Sejonhossain/IoT-Based-Hybrid-Fire-Fighting-Robot-with-Real-Time-Monitoring-and-Control-via-a-Web-Based-Dashboard/Firefighter_Circuit_Diagram.jpeg

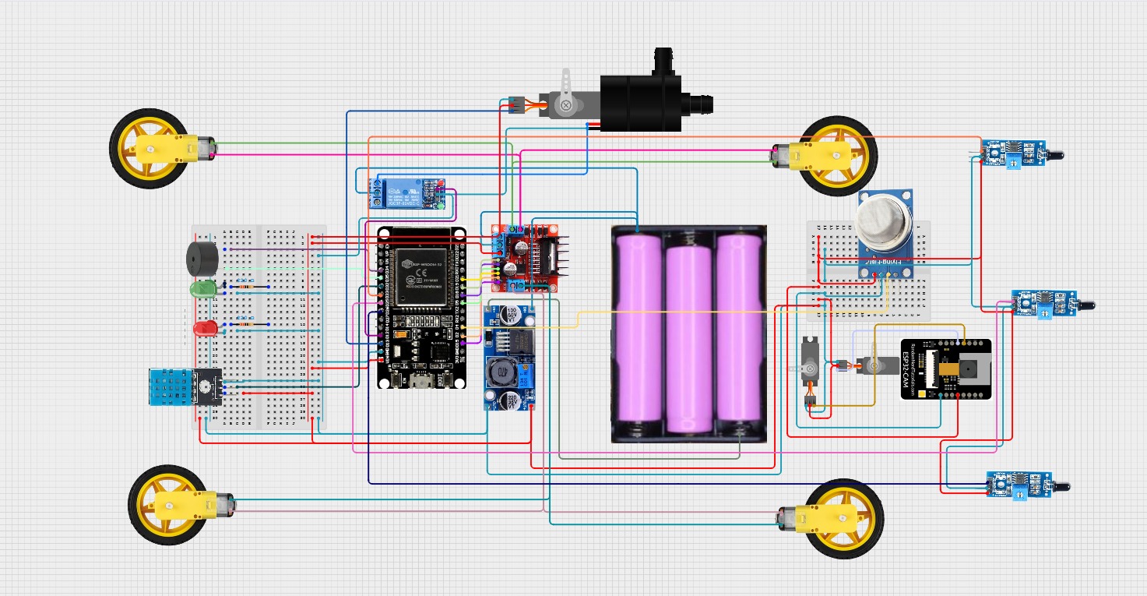
Firefighter_Circuit_Diagram.jpeg
