Sejonhossain/IoT-Based-Hybrid-Fire-Fighting-Robot-with-Real-Time-Monitoring-and-Control-via-a-Web-Based-Dashboard/Project Photos/FireFighter_Web_Dashbaord_1.jpeg

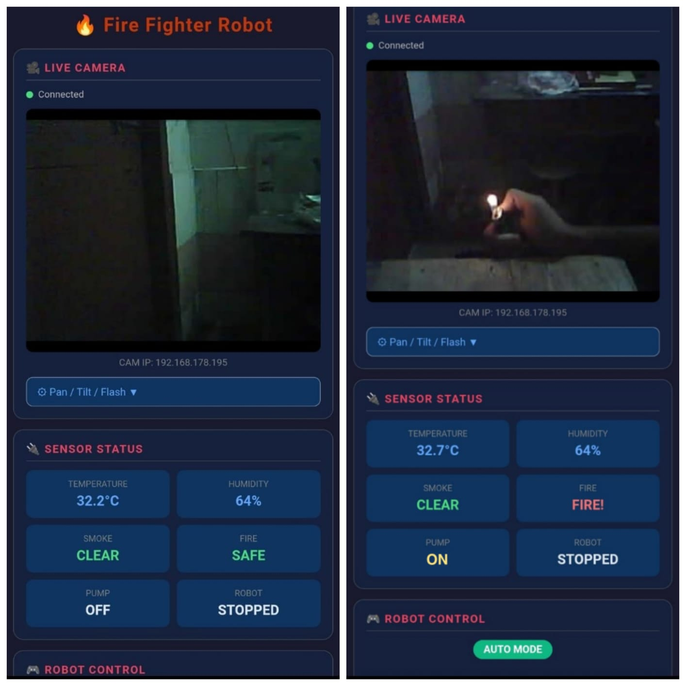
Project Photos/FireFighter_Web_Dashbaord_1.jpeg
