Sejonhossain/IoT-Based-Hybrid-Fire-Fighting-Robot-with-Real-Time-Monitoring-and-Control-via-a-Web-Based-Dashboard/Annexure/Budget.pdf

1

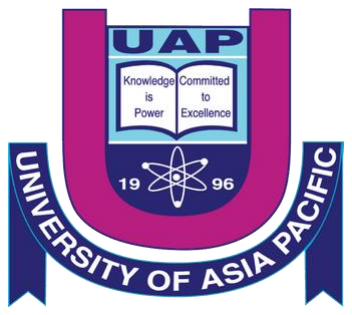
[picture p8: figure]

# University of Asia Pacific

# Department of Computer Science and Engineering

# CSE 438: Robotics Lab

# Annexure (Budget)

Submitted by: | Submitted to:
Name: Dipu Banik | Tasnim Jahin Mowla
Student ID: 22201255 | Lecturer
Name: Bivas Nandan Debnath | Department of Computer Science and Engineering

Student ID: 22201256

Name: Nazim Uddin
Student ID: 22201271

Name: Md. Sejon Hossain
Student ID: 22201272

Section: E2
Semester: 4th Year 1st Semester

2

# Budget of the Project

Number | Components | Quantity | Unit price | Total Price
1 | ESP-32 | 1 | 600 | 600
2 | Flame Sensor | 3 | 65 | 195
3 | Flammable Gas & Smoke Sensor (MQ-2) | 1 | 130 | 130
4 | Analog Temperature Sensor Module (DHT 11) | 1 | 75 | 75
5 | ESP-32 CAM | 1 | 980 | 980
6 | Gear BO Motor (TT dual shaft) | 4 | 85 | 340
7 | Robot Car Wheel | 4 | 75 | 300
8 | Servo Motor (180°) | 3 | 135 | 405
9 | L298N Motor Driver | 1 | 168 | 168
10 | Relay Module | 1 | 95 | 95
11 | Mini Water Pump (3V) | 1 | 120 | 120
12 | Buzzer | 1 | 40 | 40
13 | LED | 2 | 10 | 20
14 | 7.4V Li-ion Battery (3.7V × 2) | 4 | 200 | 800
Total Estimated Price | | | | 4268
