Sejonhossain/IoT-Based-Hybrid-Fire-Fighting-Robot-with-Real-Time-Monitoring-and-Control-via-a-Web-Based-Dashboard/Annexure/GanttChart.pdf

# University of Asia Pacific

# Department of Computer Science and Engineering

# CSE 438: Robotics Lab

# Annexure (GanttChart)

Submitted by: | Submitted to:
Name: Dipu Banik | Tasnim Jahin Mowla
Student ID: 22201255 | Lecturer
Name: Bivas Nandan Debnath | Department of Computer Science and Engineering

Student ID: 22201256

Name: Nazim Uddin
Student ID: 22201271

Name: Md. Sejon Hossain
Student ID: 22201272

Section: E2
Semester: 4th Year 1st Semester

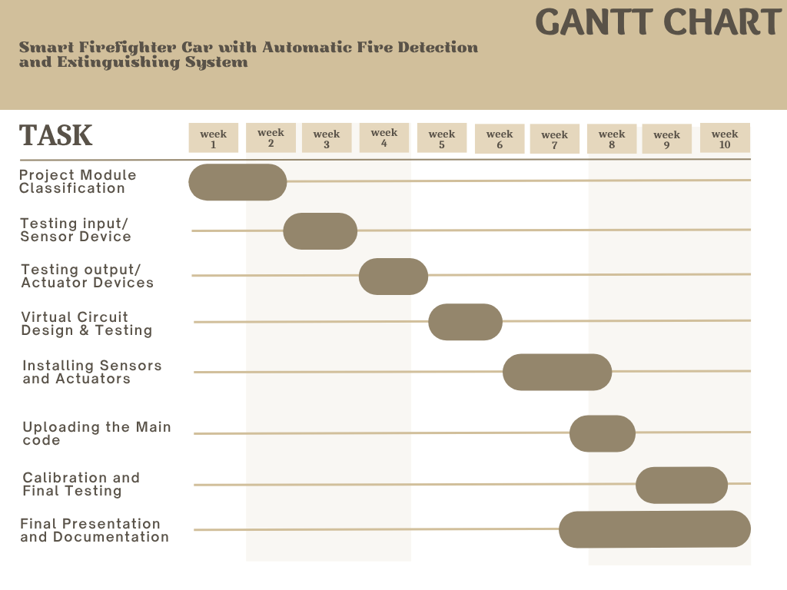
[picture p9: figure]

This Gantt chart shows our 10-week project timeline for the Smart Firefighter Car with Automatic Fire Detection and Extinguishing System. Each task is plotted against the weeks when we will work on it.

Week-wise Summary

Week 1–2: Project Module Classification

We start by breaking the project into modules (sensors, actuators, coding, etc.).

Week 2-3: Testing Input / Sensor Devices

We test sensors like the flame sensor, ultrasonic sensor and temperature sensor individually.

Week 4: Testing Output / Actuator Devices

We check actuators such as motors, relay and water pump to ensure they work properly.

Week 5-6: Virtual Circuit Design & Testing

We design and test the circuit on simulation tools before installing it on the hardware.

Week 6-8: Installing Sensors and Actuators

We physically mount all components on the firefighter car and wire them correctly.

Week 7-8: Uploading the Main Code

We upload the main program that controls the car (fire detection, water pumping, movement) and test it.

Week 9–10: Calibration and Final Testing

We tune the system, adjust sensor sensitivity and ensure smooth operation.

Week 7–10: Final Presentation and Documentation

We prepare the final report, diagrams, presentation slides and full project documentation.
