Sejonhossain/IoT-Based-Hybrid-Fire-Fighting-Robot-with-Real-Time-Monitoring-and-Control-via-a-Web-Based-Dashboard/Firefighter_Robot_Block_Diagram.png

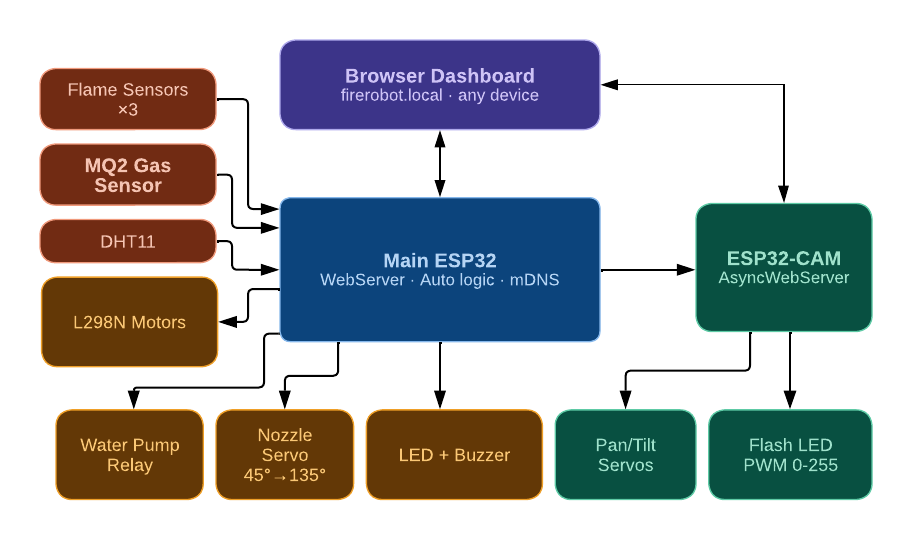
Firefighter_Robot_Block_Diagram.png
